cw8j7knmhc-del/MF35X-Tracker/tractor.png

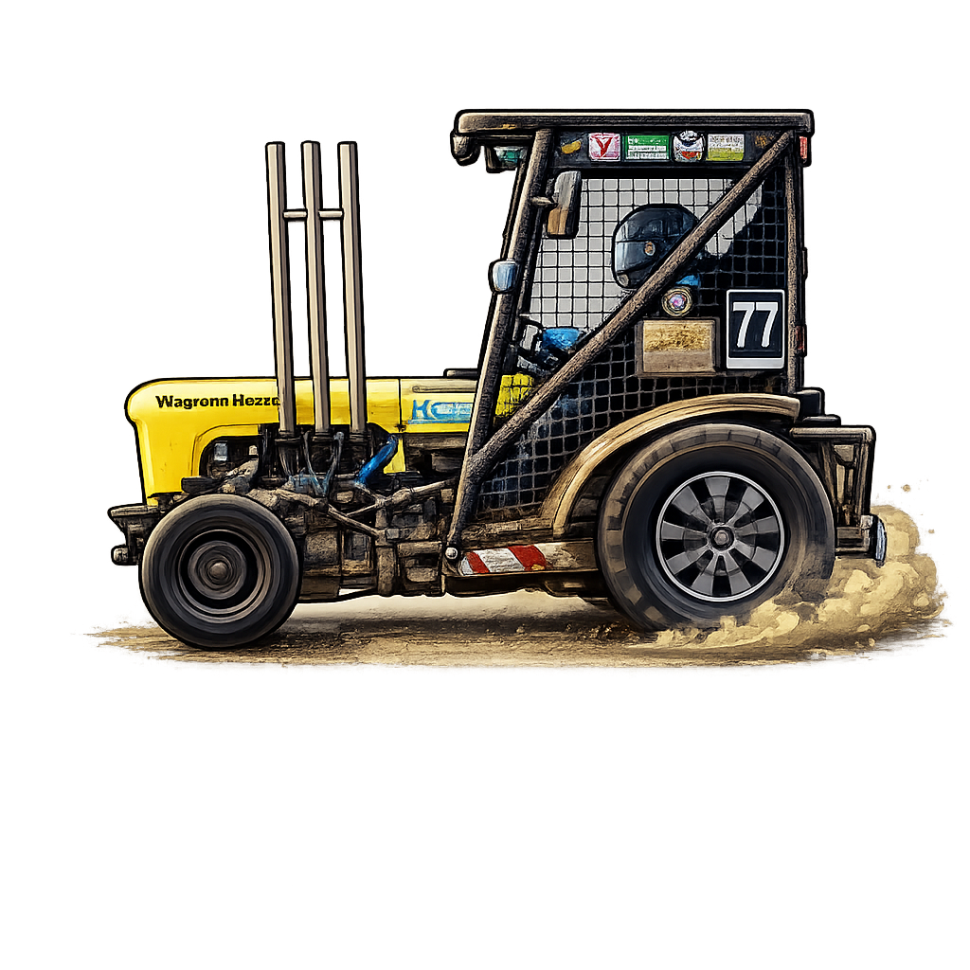
tractor.png
