cw8j7knmhc-del/MF35X-Tracker/README.md

# MF35X Tracker V9.5.1

## Einstellbare Intervalle

- 5-V-Drehzahl-Rechteckausgang: Standard 10 ms
- Drehzahl zu Firebase/Website: Standard 250 ms
- Öldruck zu Firebase/Website: Standard 100 ms
- Temperaturen: Standard 1000 ms
- GPS-Position und GPS-Geschwindigkeit: Standard 1000 ms

## Firebase-Pfad

`tracker/config/intervals`

```json
{
  "rpm_output_update_ms": 10,
  "rpm_firebase_update_ms": 250,
  "oil_pressure_update_ms": 100,
  "temperature_update_ms": 1000,
  "gps_update_ms": 1000
}
```

Der Rechteckausgang läuft kontinuierlich. Sein Wert bestimmt nur, wie oft die
Ausgangsfrequenz an die neu berechnete Drehzahl angepasst wird.

GPS-Position und GPS-Geschwindigkeit werden gemeinsam aktualisiert.

## Auf GitHub Pages ersetzen

- admin.html
- admin.js
- index.html
- script.js
- style.css

Der ESP32-Sketch muss danach einmalig an die neue Firebase-Konfiguration angepasst werden.

## Alarmstart-Fix V9.5.1

Beim Öffnen der Besucheransicht werden Alarme erst geprüft, wenn sowohl

- die gespeicherten Alarmgrenzen aus `tracker/settings`
- als auch gültige Live-Daten aus `tracker/live`

geladen wurden.

Dadurch erscheint beim Seitenstart kein kurzzeitiger falscher Öldruckalarm und es
wird auch kein falscher Eintrag in der Alarmhistorie erzeugt.

## Öldruckalarm-Fix V9.5.1

Der Öldruckalarm wird nur ausgewertet, wenn:

- eine gültige Drehzahl vorhanden ist,
- die Drehzahl mindestens 400 U/min beträgt,
- und der Motor bereits mindestens 5 Sekunden über 400 U/min läuft.

Bei `rpm = null`, `--- U/min`, `0 U/min` oder weniger als 400 U/min wird kein
Öldruckalarm angezeigt und kein entsprechender Eintrag in der Alarmhistorie erzeugt.

Damit bleibt die Anzeige bei ausgeschaltetem Motor neutral, obwohl der gemessene
Öldruck korrekt 0,0 bar beträgt.

## Layout V9.5.1

Obere Reihe:
1. Geschwindigkeit
2. Drehzahl
3. Zylindertemperatur
4. Öltemperatur
5. Öldruck

Untere Reihe:
1. Batteriespannung
2. Status
3. Verbindung
4. GPS-Qualität
5. Satelliten

Das Benachrichtigungs- und Adminfeld befindet sich als letztes Bedienfeld am Seitenende.

## Frische Live-Daten V9.5.1

Die Besucheransicht prüft jetzt den Firebase-Zeitstempel `tracker/live/timestamp`,
bevor Werte angezeigt werden.

- Alte gespeicherte Werte werden beim Öffnen nicht mehr als aktuelle Werte angezeigt.
- Das tatsächliche Updateintervall wird aus `tracker/device/uploadIntervalMs` gelesen.
- Offline-Timeout = vier Uploadintervalle, mindestens 1,5 Sekunden.
- Bei aktuell 500 ms Uploadintervall beträgt der Timeout 2 Sekunden.
- Die Anzeige „Letztes Update“ verwendet den echten Firebase-Zeitstempel.
- Verbindung und RSSI werden bei Offline ebenfalls geleert.

## Satellitenkarte V9.5.1

Die eingebettete Leaflet-Karte verwendet jetzt standardmäßig Esri World Imagery
anstelle der bisherigen OpenStreetMap-Straßenkarte.

Unverändert bleiben:
- Traktor-Marker
- automatische Positionsnachführung
- Zoom und Verschieben
- Button „In Google Maps öffnen“

## V9.5.1 – Rennauswertung vorbereitet

Neue Dateien:
- `analysis.html`
- `analysis.js`

Neue Funktionen:
- eigene Seite „Rennauswertung“
- Rennwahl über `tracker/races`
- frei wählbarer Zeitraum von/bis
- Button „Gesamtes Rennen“
- Temperaturdiagramm für Zylinderkopf, Motoröl und Getriebeöl
- optionales Diagramm für Öldruck, Drehzahl und Geschwindigkeit
- Minimum, Maximum, Durchschnitt und Zeitpunkt des Maximums
- Dauer in Warn-/Alarmbereichen für Motoröl, Zylinderkopf und Öldruck
- CSV-Export mit Semikolon-Trennung für Excel
- Adminbereich mit Rennname sowie Start/Stop-Steuerung
- separates Archivintervall `history_update_ms`, Standard 5000 ms

Geplante Firebase-Struktur:

tracker/
  races/
    race_YYYYMMDD_HHMMSS/
      name
      startedAt
      stoppedAt
      status
      history_update_ms

  history/
    race_YYYYMMDD_HHMMSS/
      <push-key>/
        timestamp
        cylinder_temp
        oil_temp
        gear_oil_temp
        oil_pressure
        rpm
        speed_kmh

  config/
    recording/
      enabled
      raceId
      raceName
      history_update_ms
      requestedAt

Wichtig:
Die aktuelle ESP32-Firmware schreibt noch keine Historie. Deshalb bleibt „Aufzeichnung starten“
im Adminbereich gesperrt, bis die spätere Firmware unter `tracker/device/historySupported`
den Wert `true` meldet.

Für effiziente Firebase-Zeitbereichsabfragen sollte später in den vorhandenen Realtime-Database-
Regeln am History-Rennknoten ein Index für `timestamp` ergänzt werden (`.indexOn`).
Die bestehenden Regeln nicht blind ersetzen; den Index nur in die vorhandene Regelstruktur integrieren.

## V9.5.1 – Kartenposition

Die Satellitenkarte befindet sich jetzt direkt unter den beiden Reihen der Live-Anzeigen.

Reihenfolge:
1. Live-Anzeigen
2. Satellitenkarte
3. Button „In Google Maps öffnen“
4. Maximalwerte / Alarmhistorie
5. Temperaturdiagramme
6. Rennauswertung
7. Benachrichtigungen / Admin am Seitenende
