cw8j7knmhc-del/MF35X-Tracker/firmware/README.md

# MF35X OTA output

Dieser Ordner wird von GitHub Actions automatisch befüllt:

- `MF35X_Livetracker_signed.bin`
- `manifest.json`

Die Binärdatei wird mit dem privaten RSA-OTA-Schlüssel signiert. Den privaten Schlüssel niemals in dieses Repository kopieren.
