cw8j7knmhc-del/MF35X-Tracker/hardware/kicad/MF35X_Tracker.kicad_sch

## KiCad design hardware/kicad/MF35X_Tracker.kicad_sch (2026-09-10)

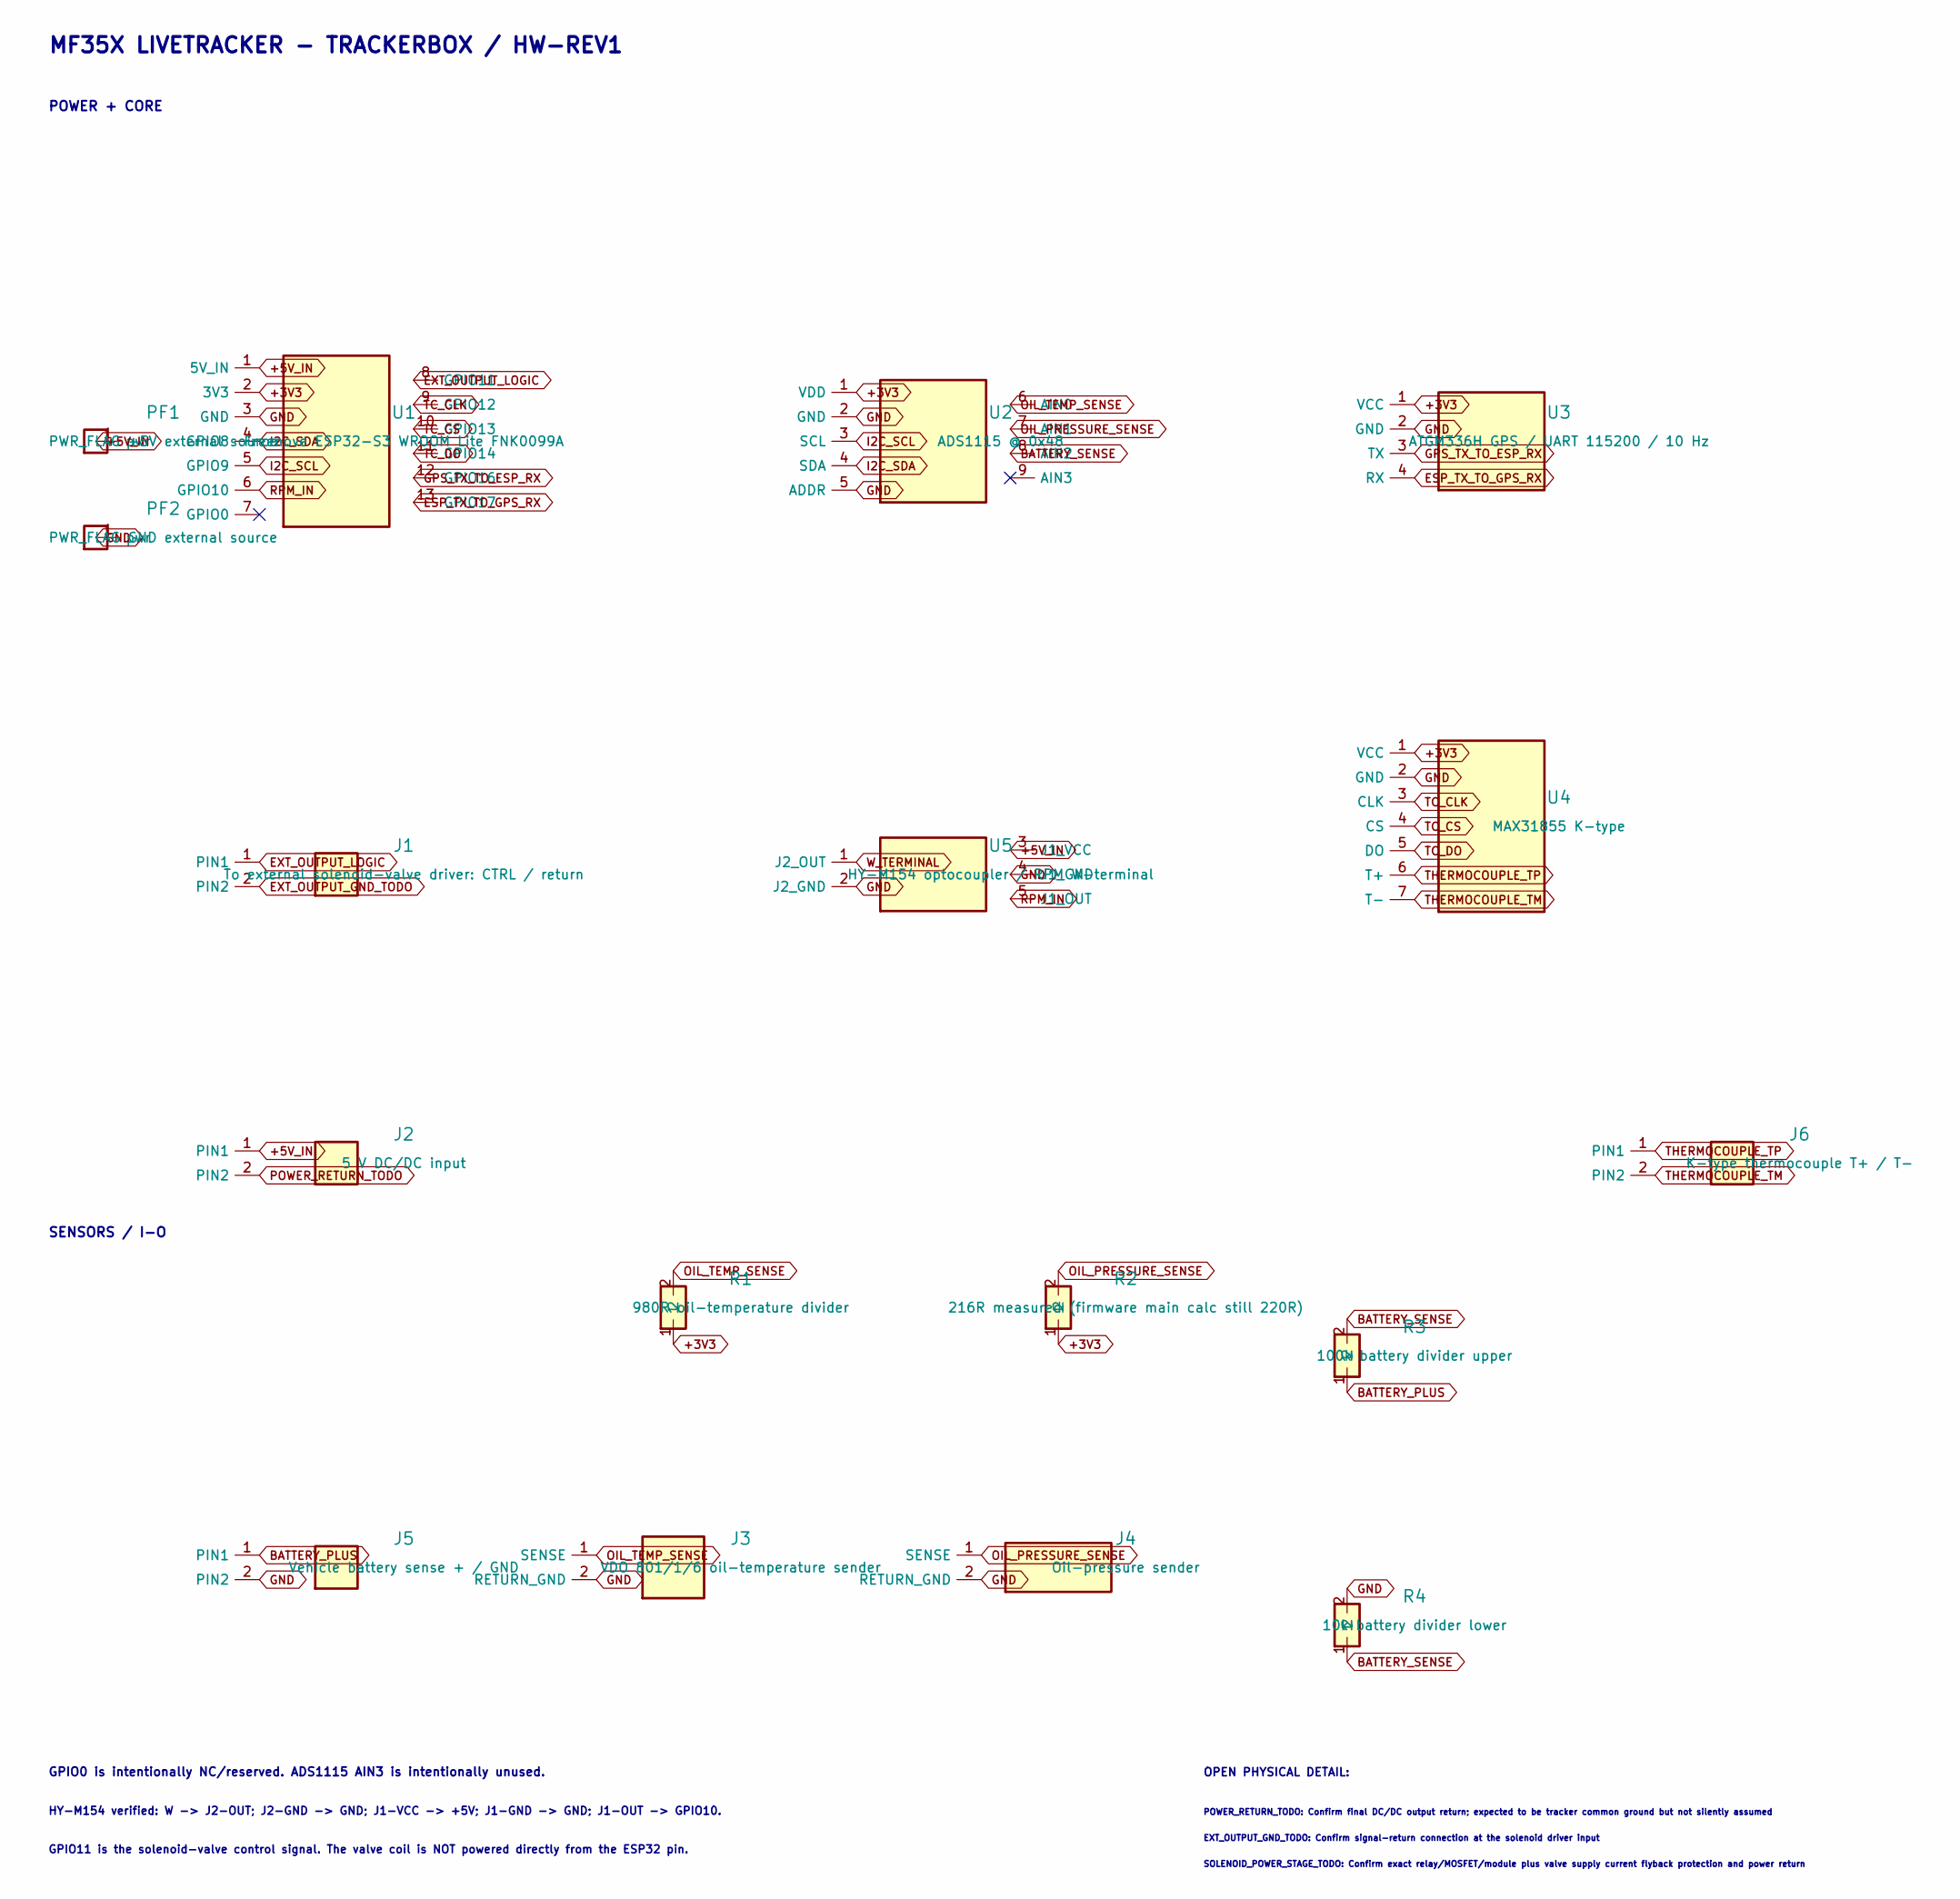
[picture p2: schematic MF35X_Tracker.kicad_sch]

Parts:
J1: To external solenoid-valve driver: CTRL / return
J2: 5 V DC/DC input
J3: VDO 801/1/6 oil-temperature sender
J4: Oil-pressure sender
J5: Vehicle battery sense + / GND
J6: K-type thermocouple T+ / T-
PF1: PWR_FLAG +5V external source
PF2: PWR_FLAG GND external source
R1: 980R oil-temperature divider
R2: 216R measured (firmware main calc still 220R)
R3: 100k battery divider upper
R4: 10k battery divider lower
U1: Freenove ESP32-S3 WROOM Lite FNK0099A
U2: ADS1115 @ 0x48
U3: ATGM336H GPS / UART 115200 / 10 Hz
U4: MAX31855 K-type
U5: HY-M154 optocoupler / RPM W-terminal

Connections:
+3V3: R1.1, R2.1, U1.2 (3V3), U2.1 (VDD), U3.1 (VCC), U4.1 (VCC)
+5V_IN: J2.1 (PIN1), PF1.1, U1.1 (5V_IN), U5.3 (J1_VCC)
BATTERY_PLUS: J5.1 (PIN1), R3.1
BATTERY_SENSE: R3.2, R4.1, U2.8 (AIN2)
ESP_TX_TO_GPS_RX: U1.13 (GPIO17), U3.4 (RX)
EXT_OUTPUT_GND_TODO: J1.2 (PIN2)
EXT_OUTPUT_LOGIC: J1.1 (PIN1), U1.8 (GPIO11)
GND: J3.2 (RETURN_GND), J4.2 (RETURN_GND), J5.2 (PIN2), PF2.1, R4.2, U1.3 (GND), U2.2 (GND), U2.5 (ADDR), U3.2 (GND), U4.2 (GND), U5.2 (J2_GND), U5.4 (J1_GND)
GPS_TX_TO_ESP_RX: U1.12 (GPIO16), U3.3 (TX)
I2C_SCL: U1.5 (GPIO9), U2.3 (SCL)
I2C_SDA: U1.4 (GPIO8), U2.4 (SDA)
OIL_PRESSURE_SENSE: J4.1 (SENSE), R2.2, U2.7 (AIN1)
OIL_TEMP_SENSE: J3.1 (SENSE), R1.2, U2.6 (AIN0)
POWER_RETURN_TODO: J2.2 (PIN2)
RPM_IN: U1.6 (GPIO10), U5.5 (J1_OUT)
TC_CLK: U1.9 (GPIO12), U4.3 (CLK)
TC_CS: U1.10 (GPIO13), U4.4 (CS)
TC_DO: U1.11 (GPIO14), U4.5 (DO)
THERMOCOUPLE_TM: J6.2 (PIN2), U4.7 (T-)
THERMOCOUPLE_TP: J6.1 (PIN1), U4.6 (T+)
W_TERMINAL: U5.1 (J2_OUT)

Notes on the sheet:
MF35X LIVETRACKER - TRACKERBOX / HW-REV1
POWER + CORE
SENSORS / I-O
GPIO0 is intentionally NC/reserved. ADS1115 AIN3 is intentionally unused.
HY-M154 verified: W -> J2-OUT; J2-GND -> GND; J1-VCC -> +5V; J1-GND -> GND; J1-OUT -> GPIO10.
GPIO11 is the solenoid-valve control signal. The valve coil is NOT powered directly from the ESP32 pin.
OPEN PHYSICAL DETAIL:
POWER_RETURN_TODO: Confirm final DC/DC output return; expected to be tracker common ground but not silently assumed
EXT_OUTPUT_GND_TODO: Confirm signal-return connection at the solenoid driver input
SOLENOID_POWER_STAGE_TODO: Confirm exact relay/MOSFET/module plus valve supply current flyback protection and power return
