cw8j7knmhc-del/MF35X-Tracker/esp32/MF35X_Livetracker/MF35X_Livetracker.ino

/*
  MF35X Livetracker V5.9.20 OTA SIGNED
  - robuste Drehzahlauswertung am W-Anschluss mit Median + Plausibilitaetsfilter
  - zusaetzliche 0,5x-Doppelflankensperre gegen nahezu exakt doppelte RPM
  - V5.9.20 Alias-Schutz: echte Frequenzspruenge werden nicht als Pulsluecken zurueckgefaltet
  - schnelle GPIO11-Steuerung verwendet ausschliesslich plausibilisierte RPM
  - RPM-Roh-/Filter-/Verwerfungsdiagnose in der Rennaufzeichnung
  - robuster ESP32-Maximalwert/Reset-Patch
  - Oeldruck-Rohdiagnose fuer Rennaufzeichnung

  Diese .ino-Datei bleibt absichtlich minimal.
  Der eigentliche Tracker-Code liegt in MF35X_Livetracker_core.hpp.
*/

#include <Arduino.h>
#include <WiFi.h>
#include <WiFiClientSecure.h>
#include <HTTPClient.h>
#include <TinyGPS++.h>
#include <Wire.h>
#include <Adafruit_ADS1X15.h>
#include <Adafruit_MAX31855.h>
#include <Preferences.h>
#include <Update.h>
#include <esp_ota_ops.h>
#include <limits.h>
#include "firmware_version.h"
#include "ota_public_key.h"
#include <freertos/FreeRTOS.h>
#include <freertos/task.h>
#include <freertos/semphr.h>

void mf35xAttachStableRpmInterrupt(int pin, int mode);

// Core-setup()/loop() umbenennen, damit die vorbereiteten Zusatzfunktionen
// sauber vor/nach dem unveraenderten Kern eingehangen werden koennen.
#define setup mf35xCoreSetup
#define loop mf35xCoreLoop
#define attachInterrupt(pin, func, mode) \
  mf35xAttachStableRpmInterrupt((pin), (mode))
#include "MF35X_Livetracker_core.hpp"
#undef attachInterrupt
#undef loop
#undef setup

#include "rpm_stable_override.hpp"

// Kleine JSON-Hilfe fuer vorzeichenbehaftete ADS1115-Rohwerte.
void jsonLongFeld(String& json, bool& erstesFeld, const char* key, long wert) {
  jsonRaw(json, erstesFeld, key, String(wert));
}

#include "v5917_patch.hpp"
#include "v5918_rpm_diagnostics.hpp"

void setup() {
  mf35xCoreSetup();
  mf35xV5917PatchSetup();
  mf35xV5918RpmDiagSetup();
}

void loop() {
  const uint32_t raceSequenceBefore = offlineSampleSequence;
  mf35xCoreLoop();
  mf35xV5917PatchLoop(raceSequenceBefore);
  mf35xV5918RpmDiagLoop(raceSequenceBefore);
}
