cw8j7knmhc-del/MF35X-Tracker/esp32/MF35X_Livetracker/ota_public_key.h

#pragma once
#include <Arduino.h>

// MF35X OTA public key. Public by design; the matching private key must stay secret.
static const uint8_t OTA_PUBLIC_KEY[] PROGMEM = R"MF35XKEY(-----BEGIN PUBLIC KEY-----
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
RQIDAQAB
-----END PUBLIC KEY-----
)MF35XKEY";

static constexpr size_t OTA_PUBLIC_KEY_LEN = sizeof(OTA_PUBLIC_KEY);
