cw8j7knmhc-del/MF35X-Tracker/esp32/MF35X_Livetracker/secrets.example.h

#pragma once

// Nur verwenden, wenn der ESP32 seine bisher gespeicherten WLAN-Daten verloren hat.
// Diese Datei als secrets.h kopieren, eigene Werte eintragen und NIEMALS zu GitHub hochladen.
#define MF35X_WIFI_SSID "DEIN_WLAN_NAME"
#define MF35X_WIFI_PASSWORD "DEIN_WLAN_PASSWORT"
