cw8j7knmhc-del/MF35X-Tracker/(commit log)

2026-08-26 Keep last known GPS position visible while ESP32 is offline
2026-08-26 Fix OTA source to confirmed V5.9.10 GPS reference
    [MF35X_Livetracker.ino, MF35X_Livetracker_core.hpp]
2026-08-26 Fix max-value reset oil-pressure tracking
2026-08-26 Add free ESP32 online/offline browser notification module
2026-08-26 Add free ESP32 online offline browser notifications
2026-08-26 Move ESP32 status notification setting out of visitor view
2026-08-26 Restrict ESP32 status notifications to admin area
2026-08-26 Load ESP32 status notifications only in admin page
2026-08-26 Keep ESP32 notifications active in visitor view
2026-08-26 Run ESP32 status monitor silently in visitor view
2026-08-26 Add reliable external-output default reset helper
    [admin-reset-fix.js]
2026-08-26 Harden all admin reset buttons
2026-08-26 Normalize admin buttons and race analysis [skip ci]
2026-08-26 V5.9.12: stromausfallsicherer Offline-Rennpuffer
    Punkt 2: dauerhafter Offline-Rennpuffer mit geordnetem Nachsenden, deterministischen Sample-IDs, GPS-UTC-Zeit, persistenter Recording-Konfiguration, Adminstatus und OPI-PSRAM-Cache.
2026-08-26 Point 3: reduce visitor Firebase load
    Gate the full visitor tracker behind the visitor login. Keep the ESP32 status monitor available before login only on browsers where the admin notification toggle is enabled, and stop status Firebase listeners when notifications are disabled.
2026-08-26 V5.9.13: move max values and alarm history to ESP32
    Point 5: Besucherclients lesen Maximalwerte und Alarmhistorie nur noch. Der ESP32 ermittelt und persistiert Maximalwerte, puffert Alarmereignisse und verarbeitet Reset/Löschen zentral. Isolierter Compile- und Syntax-Test erfolgreich.
    [MF35X_Livetracker.ino, MF35X_Livetracker_core.hpp, device_metrics_alarm.hpp]
2026-08-26 Calibrate RPM W-signal factor to 0.06512
2026-08-26 Prepare V5.9.14 RPM calibration build
2026-08-26 Release V5.9.14 RPM calibration
2026-08-26 Revert wrapper; keep only RPM calibration change
    [MF35X_Livetracker.ino]
2026-08-26 Revert version bump; keep only RPM calibration change
2026-08-26 Release V5.9.14 RPM calibration
    Bump OTA version to V5.9.14/50914; RPM calibration factor remains 0.06512.
2026-08-26 V5.9.15 stabilize RPM measurement
    [MF35X_Livetracker.ino, rpm_stable_override.hpp]
2026-08-26 V5.9.16 robust RPM median and plausibility filter
2026-08-27 Fix max value reset to use ESP32 system command
    [admin-reset-fix.js]
2026-08-27 Set race output defaults to 60 kmh and 2500/2450 rpm
2026-08-27 Stage A: add public web push config
2026-08-27 Stage A: add isolated Firebase messaging service worker
2026-08-27 Stage A: add isolated admin push receiver test
2026-08-27 Stage A: load optional push test only in admin
2026-08-27 Stage B: add isolated Cloudflare push watcher
2026-08-27 Stage B: add Cloudflare worker config example
2026-08-27 Stage B: document isolated Cloudflare push watcher
2026-08-27 Stage B: bind configured KV namespace ID
2026-08-27 Push: add per-device admin management
2026-08-27 Push: add multi-device and 10-second sensor alarms
2026-08-27 Push: document multi-device admin secret
2026-08-27 Temporary CI: test push multi-device changes
2026-08-27 Remove temporary push multi-device CI
2026-08-27 Push: update multi-device documentation
2026-08-27 Push: load device management in admin
2026-08-27 Fix push device config cache loading
    [push-stage-a.js]
2026-08-27 Remove legacy ESP32 browser notification loader
2026-08-27 Retire legacy browser ESP32 notifications
2026-08-27 Add admin remember login and oil-pressure analysis fix
2026-08-27 Fix legacy push fallback with registered devices
2026-08-27 Align admin GPIO11 defaults to 2500/2450 rpm
2026-08-27 V5.9.17 robust max reset and oil pressure diagnostics
    [MF35X_Livetracker.ino, v5917_patch.hpp]
2026-08-27 Fix V5.9.17 signed ADS raw JSON helper
    [MF35X_Livetracker.ino]
2026-08-28 Fix Cloudflare KV write usage for sensor alarm state
2026-08-28 V5.9.18 harden RPM double-edge filter and diagnostics
2026-08-28 Wire V5.9.18 RPM diagnostics into tracker loop
2026-08-28 V5.9.19: prevent RPM reacquire from locking to double edge
    [rpm_stable_override.hpp]
2026-09-10 Add hardware pinout guard and CI quality checks
    * Add canonical tracker hardware pinout
    * Add firmware to hardware pinout consistency test
    * Add pull request quality checks for pinout and firmware compile
    * Document MF35X tracker test strategy
    [pinout.csv]
2026-09-10 Test production GPIO11 control logic at boundaries (#12)
    * Add host-side GPIO11 source unit tests
    * Run GPIO11 production logic tests in CI
    * Fix extraction of GPIO11 function definition
    * Add tests for active stable GPIO11 control path
    * Test active V5.9.19 GPIO11 control path in CI
    [test_output_control_source.py, test_stable_output_control_source.py]
2026-09-10 Fix RPM gap-alias reacquisition in V5.9.20 (#14)
    * Add exact-source RPM ISR pulse-train tests
    * Run exact-source RPM ISR tests in CI
    * Run fast safety tests before firmware compile
    * Fix RPM gap normalization alias during reacquisition
    * Bump firmware version to V5.9.20
    * Document V5.9.20 RPM alias protection
    [MF35X_Livetracker.ino, rpm_stable_override.hpp, test_rpm_isr_source.py]
2026-09-10 Add machine-checkable KiCad trackerbox schematic
    Add the HW-REV1 trackerbox schematic, canonical wiring matrix, deterministic KiCad generator, hardware consistency checks and KiCad ERC CI.
    [MF35X_Tracker.kicad_sch, wiring.csv]
